notmart/theresynth/panels/theresynth-case/theresynth-case.FCStd

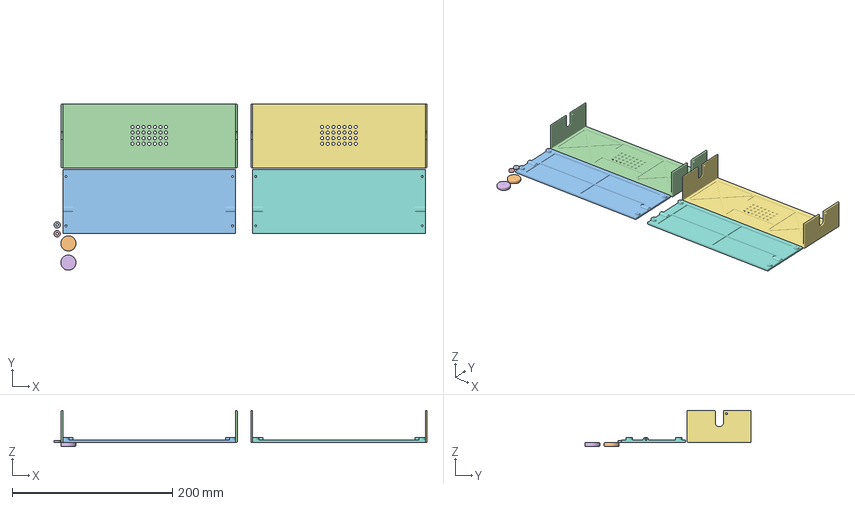
[picture p1: CAD file, 2021-06-01]
panels/theresynth-case/theresynth-case.FCStd
466.0 x 208.0 x 45.0 mm
washer
Foot
Bottom
Top
washer (Meshed)
Foot (Meshed)
Top (Meshed)
Bottom (Meshed)001
