notmart/theresynth/theresynth.kicad_pcb

## KiCad design theresynth.kicad_pcb (2021-06-01)

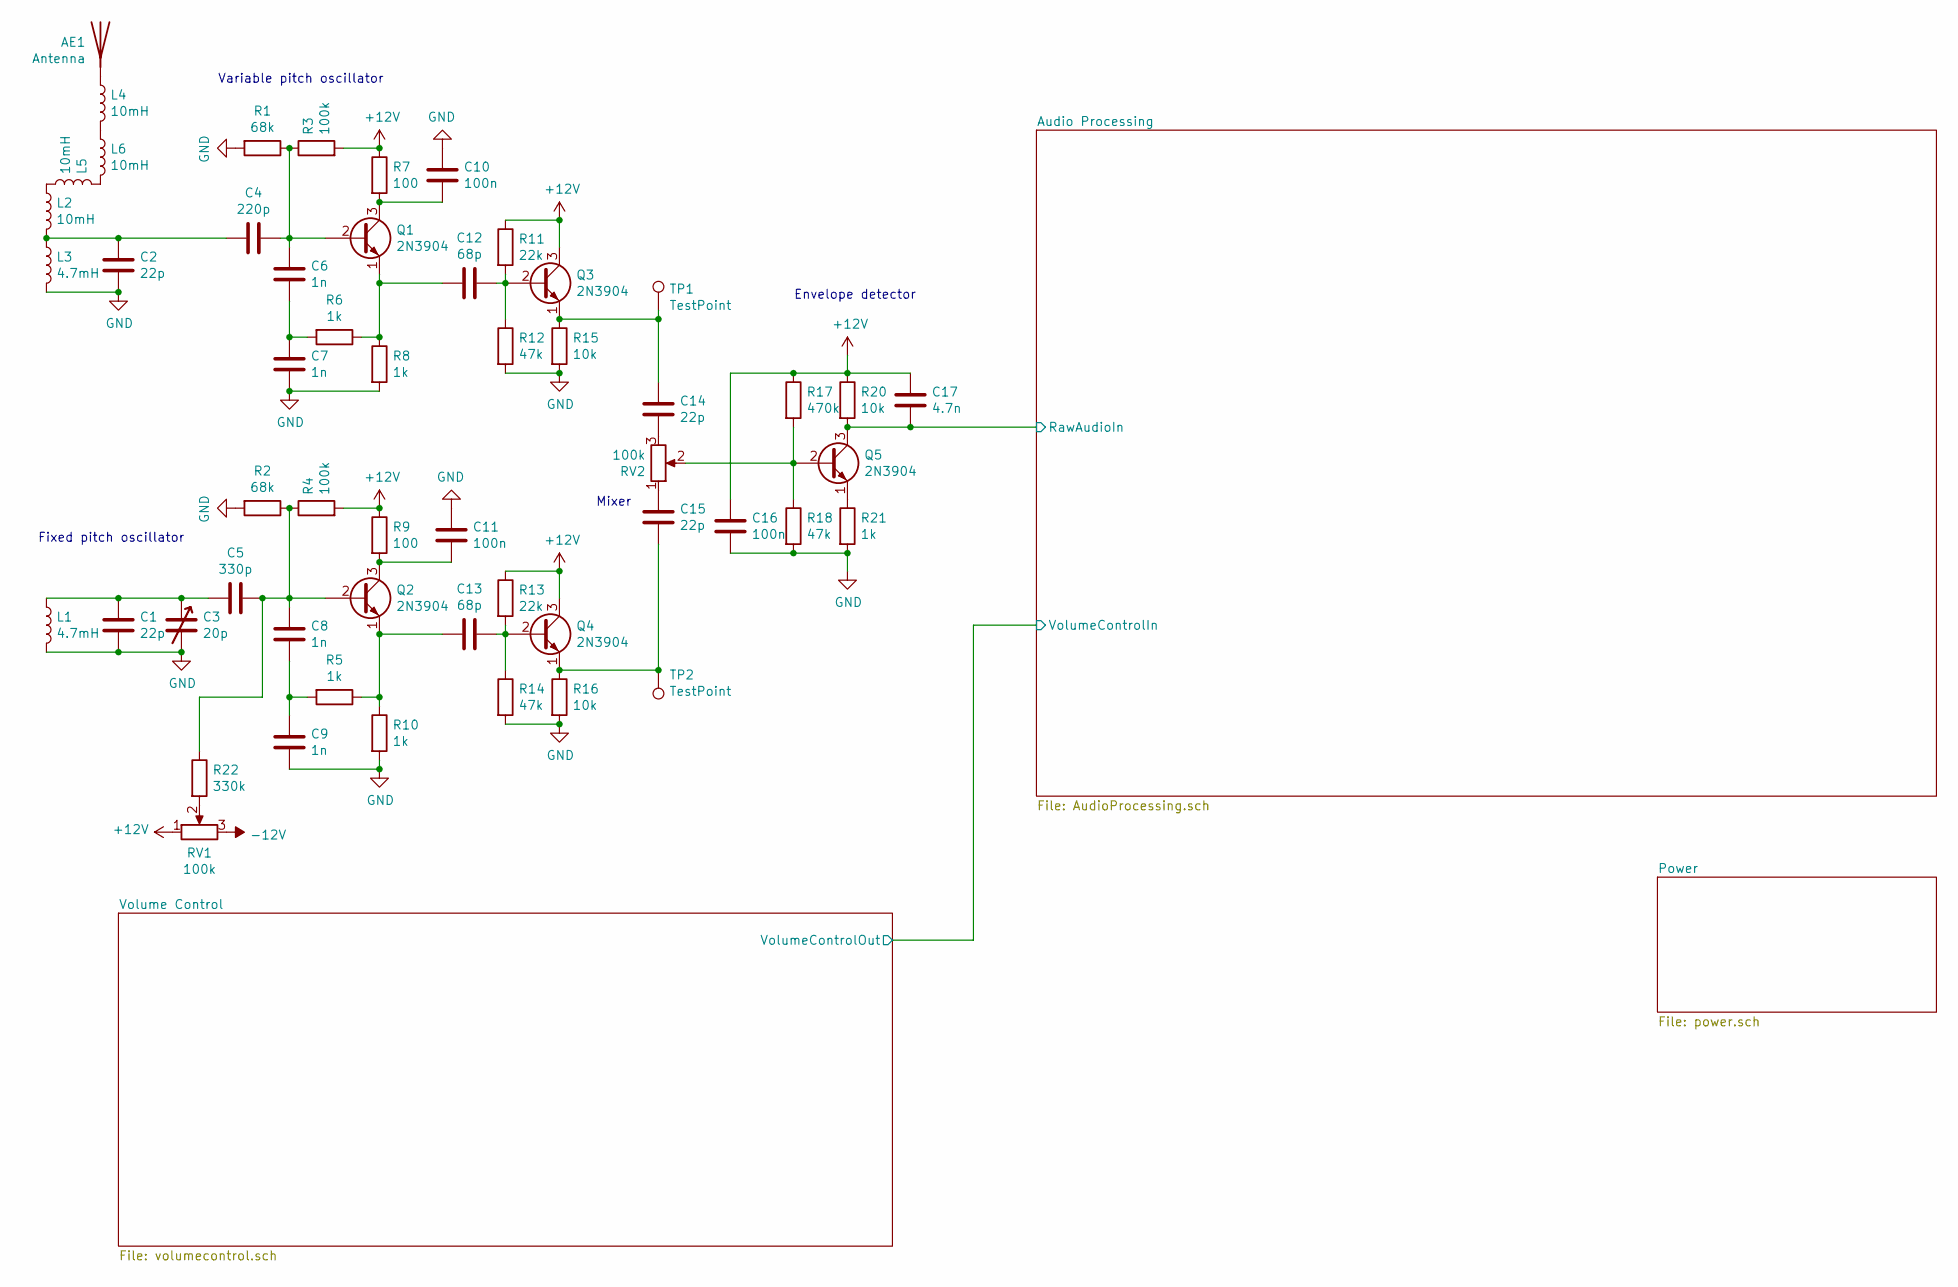
[picture p2: schematic theresynth.sch]

Parts:
AE1: Antenna; Connector_F
C1, C2, C14, C15: 22p; C_Disc_D6.0mm_W2.5mm_P5.00mm
C3: 20p; Variable_Capacitor_W6.5mm_P5.00mm
C4: 220p; C_Disc_D6.0mm_W2.5mm_P5.00mm
C5: 330p; C_Disc_D6.0mm_W2.5mm_P5.00mm
C6, C7, C8, C9: 1n; C_Rect_L7.2mm_W2.5mm_P5.00mm_FKS2_FKP2_MKS2_MKP2
C10, C11, C16: 100n; C_Rect_L7.2mm_W2.5mm_P5.00mm_FKS2_FKP2_MKS2_MKP2
C12, C13: 68p; C_Disc_D6.0mm_W2.5mm_P5.00mm
C17: 4.7n; C_Rect_L7.2mm_W2.5mm_P5.00mm_FKS2_FKP2_MKS2_MKP2
L1, L3: 4.7mH; L_Axial_L12.0mm_D5.0mm_P15.24mm_Horizontal_Fastron_MISC
L2, L4, L5, L6: 10mH; L_Radial_D12.5mm_P7.00mm_Fastron_09HCP
Q1, Q2, Q3, Q4, Q5: 2N3904; TO-92_Inline_Wide
R1, R2: 68k; R_Axial_DIN0204_L3.6mm_D1.6mm_P7.62mm_Horizontal
R3, R4: 100k; R_Axial_DIN0204_L3.6mm_D1.6mm_P7.62mm_Horizontal
R5, R6, R8, R10, R21: 1k; R_Axial_DIN0204_L3.6mm_D1.6mm_P7.62mm_Horizontal
R7, R9: 100; R_Axial_DIN0204_L3.6mm_D1.6mm_P7.62mm_Horizontal
R11, R13: 22k; R_Axial_DIN0204_L3.6mm_D1.6mm_P7.62mm_Horizontal
R12, R14, R18: 47k; R_Axial_DIN0204_L3.6mm_D1.6mm_P7.62mm_Horizontal
R15, R16, R20: 10k; R_Axial_DIN0204_L3.6mm_D1.6mm_P7.62mm_Horizontal
R17: 470k; R_Axial_DIN0204_L3.6mm_D1.6mm_P7.62mm_Horizontal
R22: 330k; R_Axial_DIN0204_L3.6mm_D1.6mm_P7.62mm_Horizontal
RV1, RV2: 100k; Potentiometer_Alps_RK163_Single_Horizontal
TP1, TP2: TestPoint; TestPoint_THTPad_1.0x1.0mm_Drill0.5mm

Connections:
+12V: C16.1, C17.1, Q3.3 (C), Q4.3 (C), R3.2, R4.2, R7.1, R9.1, R11.1, R13.1, R17.1, R20.1, RV1.1; also elsewhere on the board
-12V: RV1.3; also elsewhere on the board
/Audio Processing/RawAudioIn: C17.2, Q5.3 (C), R20.2; also elsewhere on the board
GND: C1.2, C2.2, C3.2, C7.2, C9.2, C10.1, C11.1, C16.2, L1.2, L3.2, R1.2, R2.2, R8.2, R10.2, R12.2, R14.2, R15.2, R16.2, R18.2, R21.2; also elsewhere on the board
unnamed: AE1.1, L4.1
unnamed: C1.1, C3.1, C5.2, L1.1
unnamed: C2.1, C4.1, L2.2, L3.1
unnamed: C4.2, C6.1, Q1.2 (B), R1.1, R3.1
unnamed: C5.1, C8.1, Q2.2 (B), R2.1, R4.1, R22.1
unnamed: C6.2, C7.1, R6.2
unnamed: C8.2, C9.1, R5.2
unnamed: C10.2, Q1.3 (C), R7.2
unnamed: C11.2, Q2.3 (C), R9.2
unnamed: C12.1, Q3.2 (B), R11.2, R12.1
unnamed: C12.2, Q1.1 (E), R6.1, R8.1
unnamed: C13.1, Q4.2 (B), R13.2, R14.1
unnamed: C13.2, Q2.1 (E), R5.1, R10.1
unnamed: C14.1, Q3.1 (E), R15.1, TP1.1
unnamed: C14.2, RV2.3
unnamed: C15.1, RV2.1
unnamed: C15.2, Q4.1 (E), R16.1, TP2.1
unnamed: L2.1, L5.2
unnamed: L4.2, L6.1
unnamed: L5.1, L6.2
unnamed: Q5.1 (E), R21.1
unnamed: Q5.2 (B), R17.2, R18.1, RV2.2
unnamed: R22.2, RV1.2

Notes on the sheet:
Variable pitch oscillator
Fixed pitch oscillator
Envelope detector
Mixer

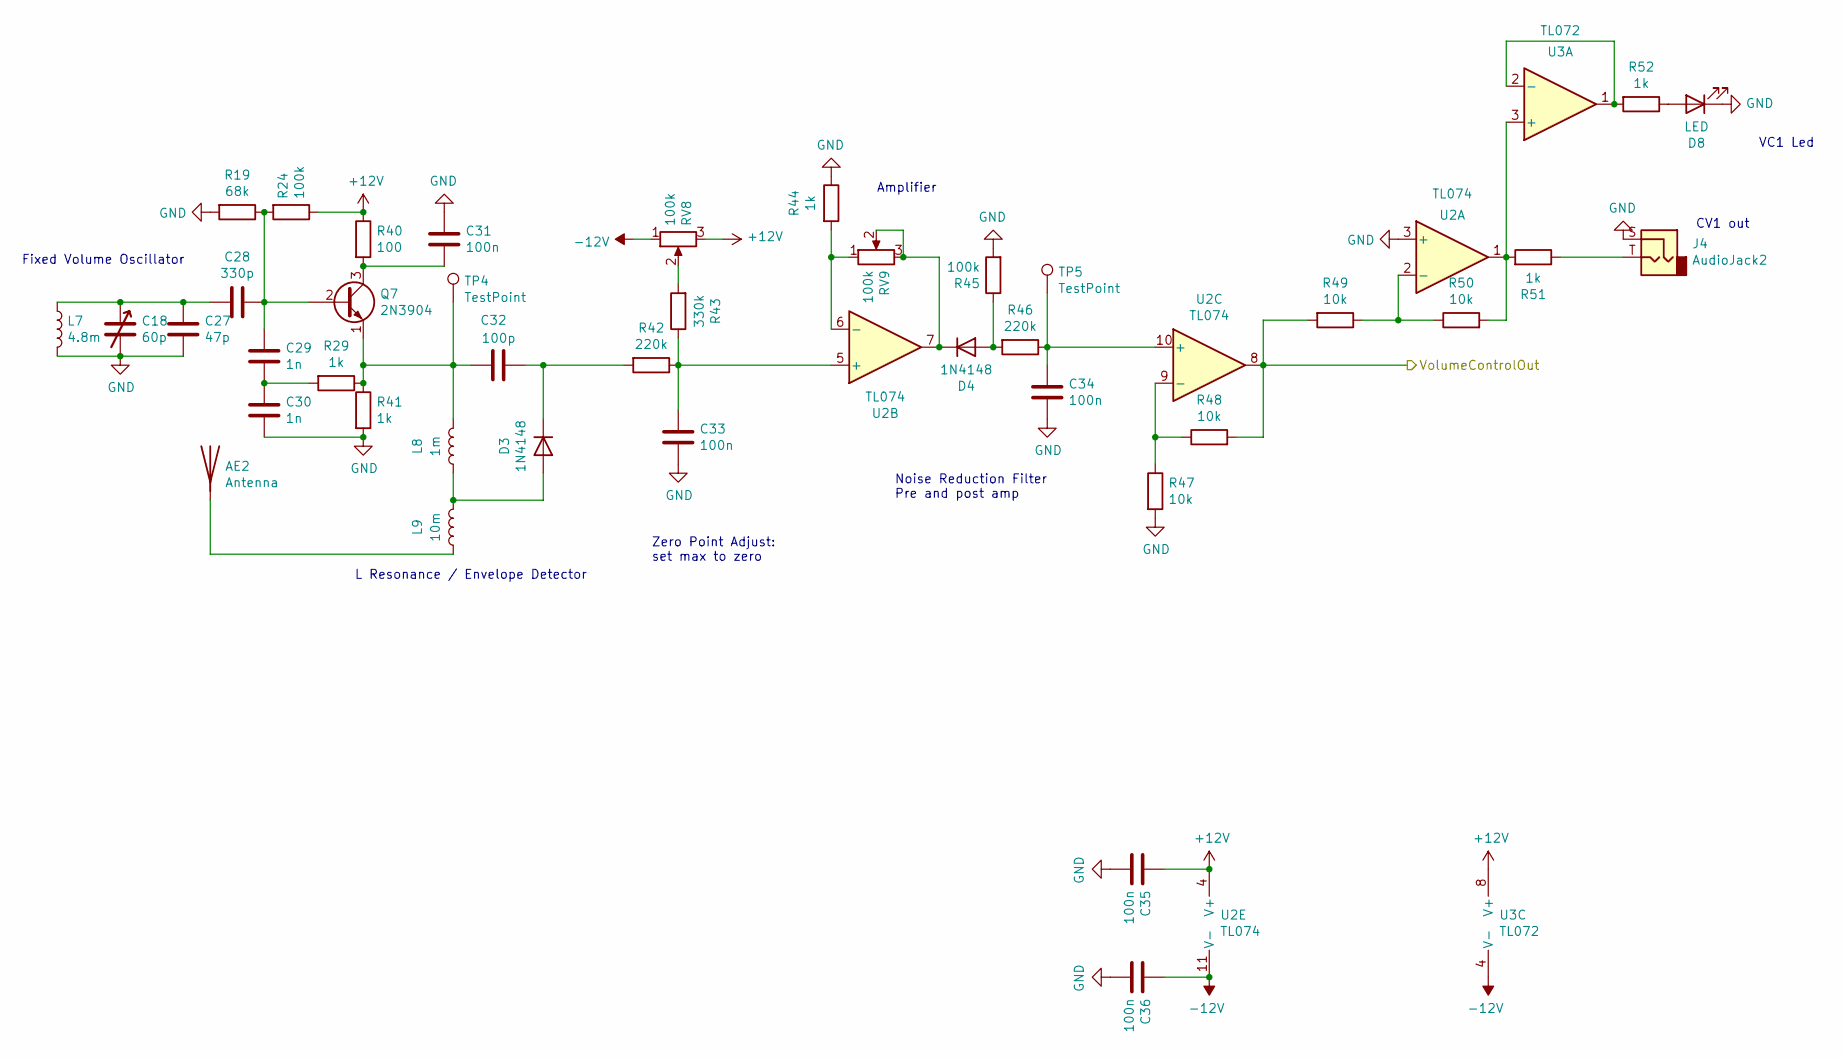
[picture p3: schematic volumecontrol.sch]

Parts:
AE2: Antenna; Connector_F
C18: 60p; Variable_Capacitor_W6.5mm_P5.00mm
C27: 47p; C_Disc_D6.0mm_W2.5mm_P5.00mm
C28: 330p; C_Disc_D6.0mm_W2.5mm_P5.00mm
C29, C30: 1n; C_Rect_L7.2mm_W2.5mm_P5.00mm_FKS2_FKP2_MKS2_MKP2
C31, C33, C34, C35, C36: 100n; C_Rect_L7.2mm_W2.5mm_P5.00mm_FKS2_FKP2_MKS2_MKP2
C32: 100p; C_Disc_D6.0mm_W2.5mm_P5.00mm
D3, D4: 1N4148; D_DO-34_SOD68_P7.62mm_Horizontal
D8: LED; LED_D3.0mm
J4: AudioJack2; PJ302M
L7: 4.8m; L_Axial_L12.0mm_D5.0mm_P15.24mm_Horizontal_Fastron_MISC
L8: 1m; L_Axial_L12.0mm_D5.0mm_P15.24mm_Horizontal_Fastron_MISC
L9: 10m; L_Radial_D12.5mm_P7.00mm_Fastron_09HCP
Q7: 2N3904; TO-92_Inline_Wide
R19: 68k; R_Axial_DIN0204_L3.6mm_D1.6mm_P7.62mm_Horizontal
R24, R45: 100k; R_Axial_DIN0204_L3.6mm_D1.6mm_P7.62mm_Horizontal
R29, R41, R44, R51, R52: 1k; R_Axial_DIN0204_L3.6mm_D1.6mm_P7.62mm_Horizontal
R40: 100; R_Axial_DIN0204_L3.6mm_D1.6mm_P7.62mm_Horizontal
R42, R46: 220k; R_Axial_DIN0204_L3.6mm_D1.6mm_P7.62mm_Horizontal
R43: 330k; R_Axial_DIN0204_L3.6mm_D1.6mm_P7.62mm_Horizontal
R47, R48, R49, R50: 10k; R_Axial_DIN0204_L3.6mm_D1.6mm_P7.62mm_Horizontal
RV8: 100k; Potentiometer_Bourns_3296W_Vertical
RV9: 100k; Potentiometer_Bourns_3386P_Vertical
TP4, TP5: TestPoint; TestPoint_THTPad_1.0x1.0mm_Drill0.5mm
U2: TL074; DIP-14_W7.62mm_LongPads
U3: TL072; DIP-8_W7.62mm_LongPads

Connections:
+12V: C35.1, R24.1, R40.1, RV8.3, U2.4 (V+), U3.8 (V+); also elsewhere on the board
-12V: C36.1, RV8.1, U2.11 (V-), U3.4 (V-); also elsewhere on the board
/Audio Processing/VolumeControlIn: R48.2, R49.2, U2.8; also elsewhere on the board
GND: C18.2, C27.2, C30.2, C31.1, C33.2, C34.2, C35.2, C36.2, D8.1 (K), J4.S, L7.2, R19.2, R41.2, R44.1, R45.2, R47.2, U2.3 (+); also elsewhere on the board
unnamed: AE2.1, L9.1
unnamed: C18.1, C27.1, C28.2, L7.1
unnamed: C28.1, C29.1, Q7.2 (B), R19.1, R24.2
unnamed: C29.2, C30.1, R29.2
unnamed: C31.2, Q7.3 (C), R40.2
unnamed: C32.1, L8.2, Q7.1 (E), R29.1, R41.1, TP4.1
unnamed: C32.2, D3.1 (K), R42.2
unnamed: C33.1, R42.1, R43.1, U2.5 (+)
unnamed: C34.1, R46.1, TP5.1, U2.10 (+)
unnamed: D3.2 (A), L8.1, L9.2
unnamed: D4.1 (K), RV9.2, RV9.3, U2.7
unnamed: D4.2 (A), R45.1, R46.2
unnamed: D8.2 (A), R52.1
unnamed: J4.T, R51.1
unnamed: R43.2, RV8.2
unnamed: R44.2, RV9.1, U2.6 (-)
unnamed: R47.1, R48.1, U2.9 (-)
unnamed: R49.1, R50.1, U2.2 (-)
unnamed: R50.2, R51.2, U2.1, U3.3 (+)
unnamed: R52.2, U3.1, U3.2 (-)

Notes on the sheet:
Fixed Volume Oscillator
L Resonance / Envelope Detector
Zero Point Adjust: set max to zero
Amplifier
Noise Reduction Filter Pre and post amp
VC1 Led
CV1 out

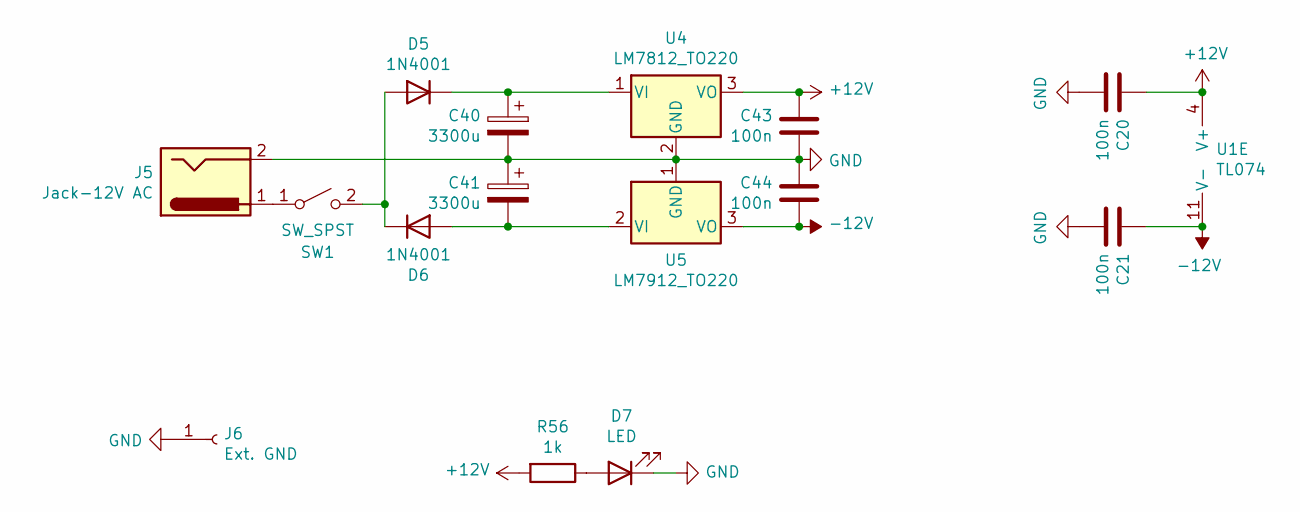
[picture p4: schematic power.sch]

Parts:
C20, C21, C43, C44: 100n; C_Rect_L7.2mm_W2.5mm_P5.00mm_FKS2_FKP2_MKS2_MKP2
C40, C41: 3300u; CP_Radial_D13.0mm_P5.00mm
D5, D6: 1N4001; D_DO-35_SOD27_P7.62mm_Horizontal
D7: LED; LED_D3.0mm
J5: Jack-12V AC; BarrelJack_Horizontal
J6: Ext. GND; Pin_D1.4mm_L8.5mm_W2.8mm_FlatFork
R56: 1k; R_Axial_DIN0204_L3.6mm_D1.6mm_P7.62mm_Horizontal
SW1: SW_SPST; Horizontal_SPDT
U1: TL074; DIP-14_W7.62mm_LongPads
U4: LM7812_TO220; TO-220-3_Vertical
U5: LM7912_TO220; TO-220-3_Vertical

Connections:
+12V: C20.1, C43.1, R56.2, U1.4 (V+), U4.3 (VO); also elsewhere on the board
-12V: C21.1, C44.2, U1.11 (V-), U5.3 (VO); also elsewhere on the board
GND: C20.2, C21.2, C40.2, C41.1, C43.2, C44.1, D7.1 (K), J5.2, J6.1, U4.2 (GND), U5.1 (GND); also elsewhere on the board
unnamed: C40.1, D5.1 (K), U4.1 (VI)
unnamed: C41.2, D6.2 (A), U5.2 (VI)
unnamed: D5.2 (A), D6.1 (K), SW1.2 (B)
unnamed: D7.2 (A), R56.1
unnamed: J5.1, SW1.1 (A)

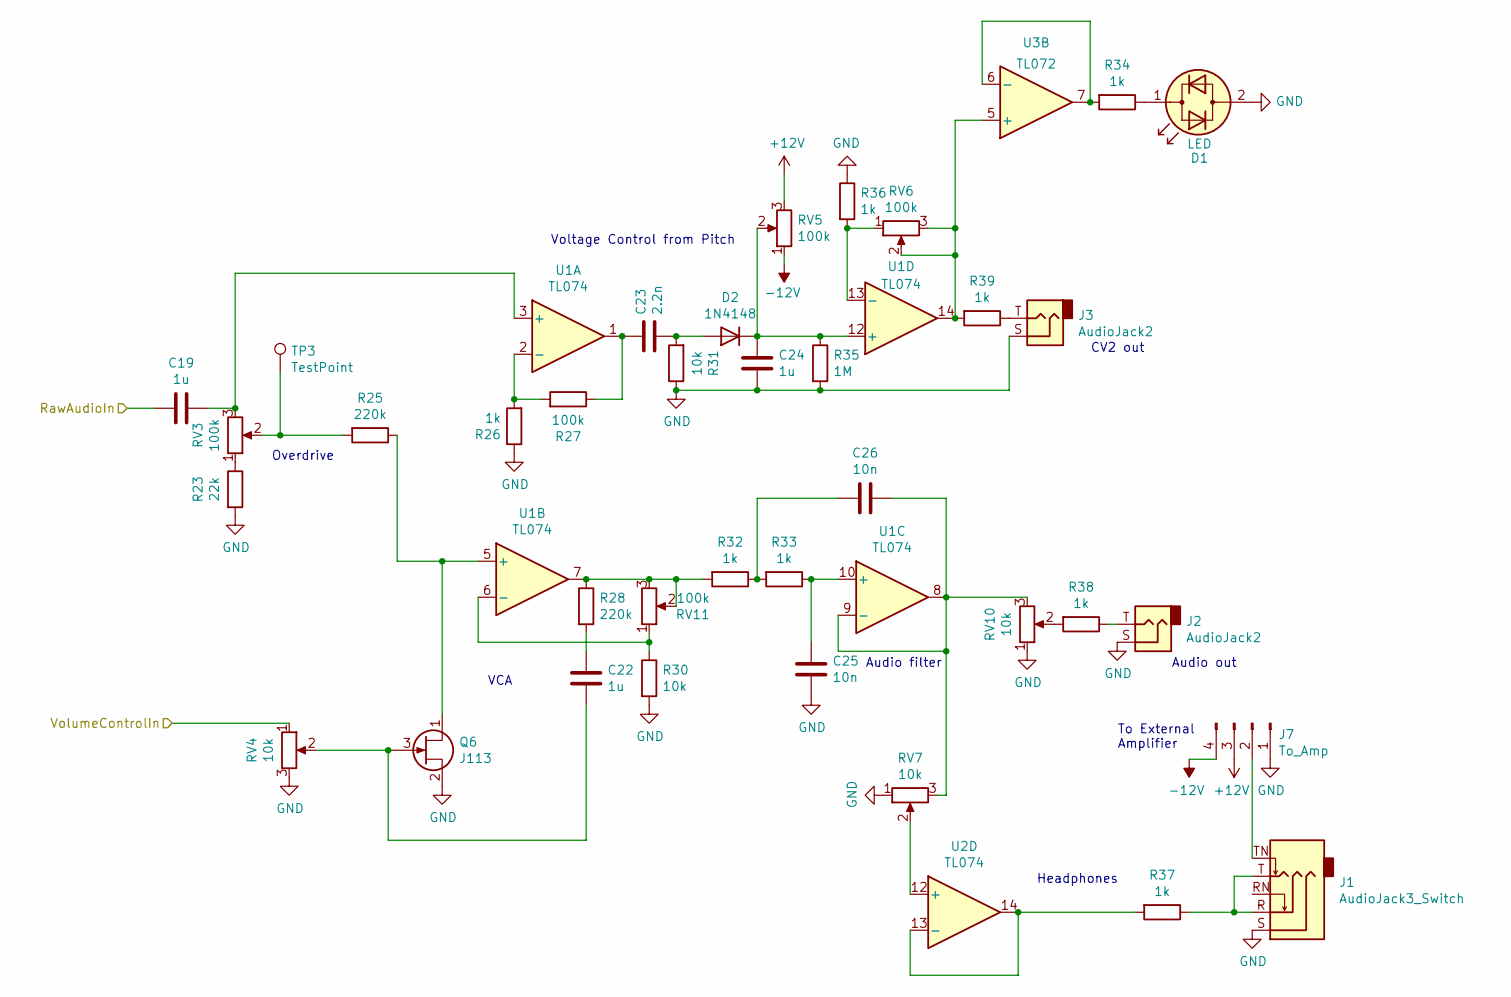
[picture p5: schematic AudioProcessing.sch]

Parts:
C19, C22, C24: 1u; C_Rect_L7.0mm_W6.0mm_P5.00mm
C23: 2.2n; C_Rect_L7.2mm_W2.5mm_P5.00mm_FKS2_FKP2_MKS2_MKP2
C25, C26: 10n; C_Rect_L7.2mm_W2.5mm_P5.00mm_FKS2_FKP2_MKS2_MKP2
D1: LED; LED_D3.0mm
D2: 1N4148; D_DO-34_SOD68_P7.62mm_Horizontal
J1: AudioJack3_Switch; Jack_3.5mm_Ledino_KB3SPRS_Horizontal
J2, J3: AudioJack2; PJ302M
J7: To_Amp; PinHeader_1x04_P2.54mm_Vertical
Q6: J113; TO-92_Inline_Wide
R23: 22k; R_Axial_DIN0204_L3.6mm_D1.6mm_P7.62mm_Horizontal
R25, R28: 220k; R_Axial_DIN0204_L3.6mm_D1.6mm_P7.62mm_Horizontal
R26, R32, R33, R34, R36, R37, R38, R39: 1k; R_Axial_DIN0204_L3.6mm_D1.6mm_P7.62mm_Horizontal
R27: 100k; R_Axial_DIN0204_L3.6mm_D1.6mm_P7.62mm_Horizontal
R30, R31: 10k; R_Axial_DIN0204_L3.6mm_D1.6mm_P7.62mm_Horizontal
R35: 1M; R_Axial_DIN0204_L3.6mm_D1.6mm_P7.62mm_Horizontal
RV3: 100k; Potentiometer_Alps_RK163_Single_Horizontal
RV4: 10k; Potentiometer_Bourns_3386P_Vertical
RV5: 100k; Potentiometer_Bourns_3296W_Vertical
RV6, RV11: 100k; Potentiometer_Bourns_3386P_Vertical
RV7, RV10: 10k; Potentiometer_Alps_RK163_Single_Horizontal
TP3: TestPoint; TestPoint_THTPad_1.0x1.0mm_Drill0.5mm
U1, U2: TL074; DIP-14_W7.62mm_LongPads
U3: TL072; DIP-8_W7.62mm_LongPads

Connections:
+12V: J7.3, RV5.3; also elsewhere on the board
-12V: J7.4, RV5.1; also elsewhere on the board
/Audio Processing/RawAudioIn: C19.2; also elsewhere on the board
/Audio Processing/VolumeControlIn: RV4.1; also elsewhere on the board
GND: C24.2, C25.2, D1.2 (AK), J1.S, J2.S, J3.S, J7.1, Q6.2 (S), R23.2, R26.1, R30.2, R31.1, R35.2, R36.1, RV4.3, RV7.1, RV10.1; also elsewhere on the board
unnamed: C19.1, RV3.3, U1.3 (+)
unnamed: C22.1, R28.2
unnamed: C22.2, Q6.3 (G), RV4.2
unnamed: C23.1, D2.2 (A), R31.2
unnamed: C23.2, R27.1, U1.1
unnamed: C24.1, D2.1 (K), R35.1, RV5.2, U1.12 (+)
unnamed: C25.1, R33.1, U1.10 (+)
unnamed: C26.1, RV7.3, RV10.3, U1.8, U1.9 (-)
unnamed: C26.2, R32.1, R33.2
unnamed: D1.1 (KA), R34.1
unnamed: J1.R, J1.T, R37.1
unnamed: J1.TN, J7.2
unnamed: J2.T, R38.1
unnamed: J3.T, R39.1
unnamed: Q6.1 (D), R25.1, U1.5 (+)
unnamed: R23.1, RV3.1
unnamed: R25.2, RV3.2, TP3.1
unnamed: R26.2, R27.2, U1.2 (-)
unnamed: R28.1, R32.2, RV11.2, RV11.3, U1.7
unnamed: R30.1, RV11.1, U1.6 (-)
unnamed: R34.2, U3.6 (-), U3.7
unnamed: R36.2, RV6.1, U1.13 (-)
unnamed: R37.2, U2.13 (-), U2.14
unnamed: R38.2, RV10.2
unnamed: R39.2, RV6.2, RV6.3, U1.14, U3.5 (+)
unnamed: RV7.2, U2.12 (+)

Notes on the sheet:
VCA
Overdrive
Audio filter
Audio out
Voltage Control from Pitch
CV2 out
Headphones
To External Amplifier

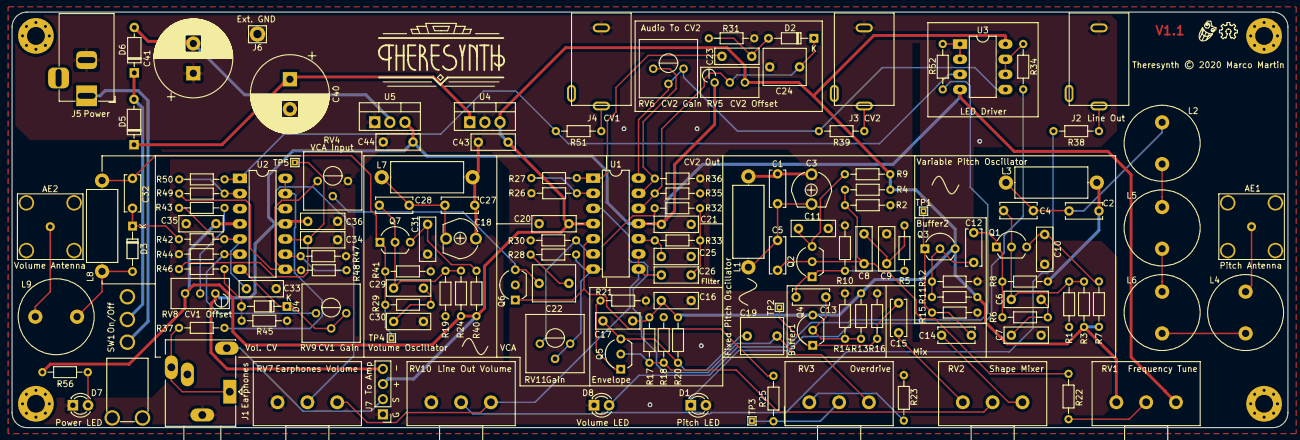
[picture p6: board theresynth.kicad_pcb from above]

Board: 2 copper layers, 214.0 x 69.7 mm, 148 parts (0 on the bottom side), 79 nets.
