notmart/theresynth/(commit log)

2020-09-17 completely connected
    [theresynth.kicad_pcb, theresynth.sch, volumecontrol.sch]
2020-09-22 add phones output
    [theresynth.kicad_pcb, theresynth.sch, volumecontrol.sch]
2020-10-07 removed 2 opamp units
    [AudioProcessing.sch, power.sch, theresynth.kicad_pcb, theresynth.sch, volumecontrol.sch]
2020-10-12 full connection before relayouting labels
    [AudioProcessing.sch, power.sch, theresynth.kicad_pcb, theresynth.sch, volumecontrol.sch]
2020-10-16 migrate audio processing to new sheet
    [power.sch, theresynth.kicad_pcb, theresynth.sch, volumecontrol.sch]
2020-10-27 1.0 for fabrication
    [AudioProcessing.sch, theresynth.kicad_pcb, volumecontrol.sch]
2021-06-01 add panels
    [AudioProcessing.sch, power.sch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]
2021-12-06 add gerber
    [theresynth-B_Cu.gbr, theresynth-B_Mask.gbr, theresynth-B_Paste.gbr, theresynth-B_SilkS.gbr, theresynth-Edge_Cuts.gbr, theresynth-F_Cu.gbr, theresynth-F_Mask.gbr, theresynth-F_Paste.gbr]
