notmart/theresynth/(notices)

Notices in the files:
panels/theresynth-backpanel/theresynth-backpanel.kicad_pcb:
© 2020 Marco Martin
theresynth.kicad_pcb:
Theresynth © 2020 Marco Martin
